Tech500/EoRa-PI-Foundation/Docs/Pin # to GPIO #.jpg

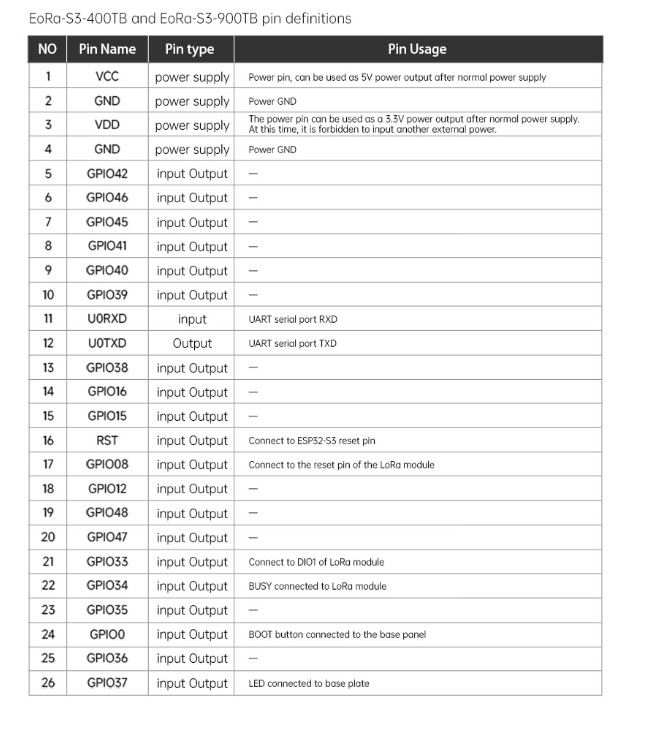
Docs/Pin # to GPIO #.jpg
