Tech500/EoRa-PI-Foundation/Docs/Pin callouts.jpg

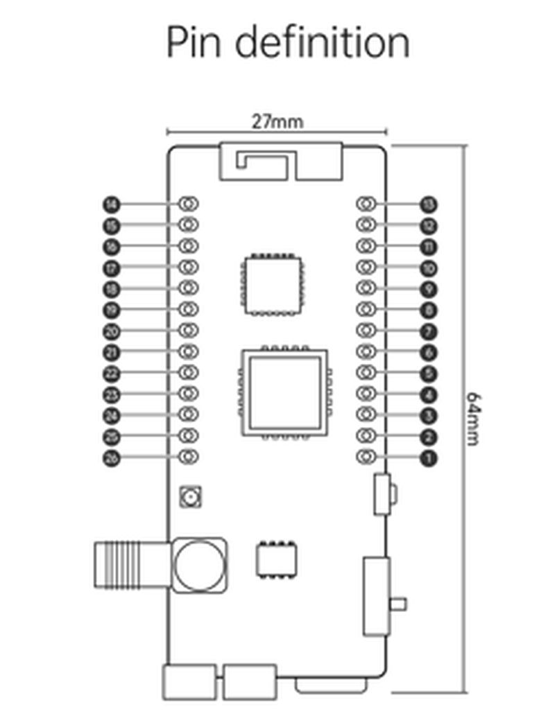
Docs/Pin callouts.jpg
