Tech500/EoRa-PI-Foundation/EoRa-PI-Foundation --Receiver.png

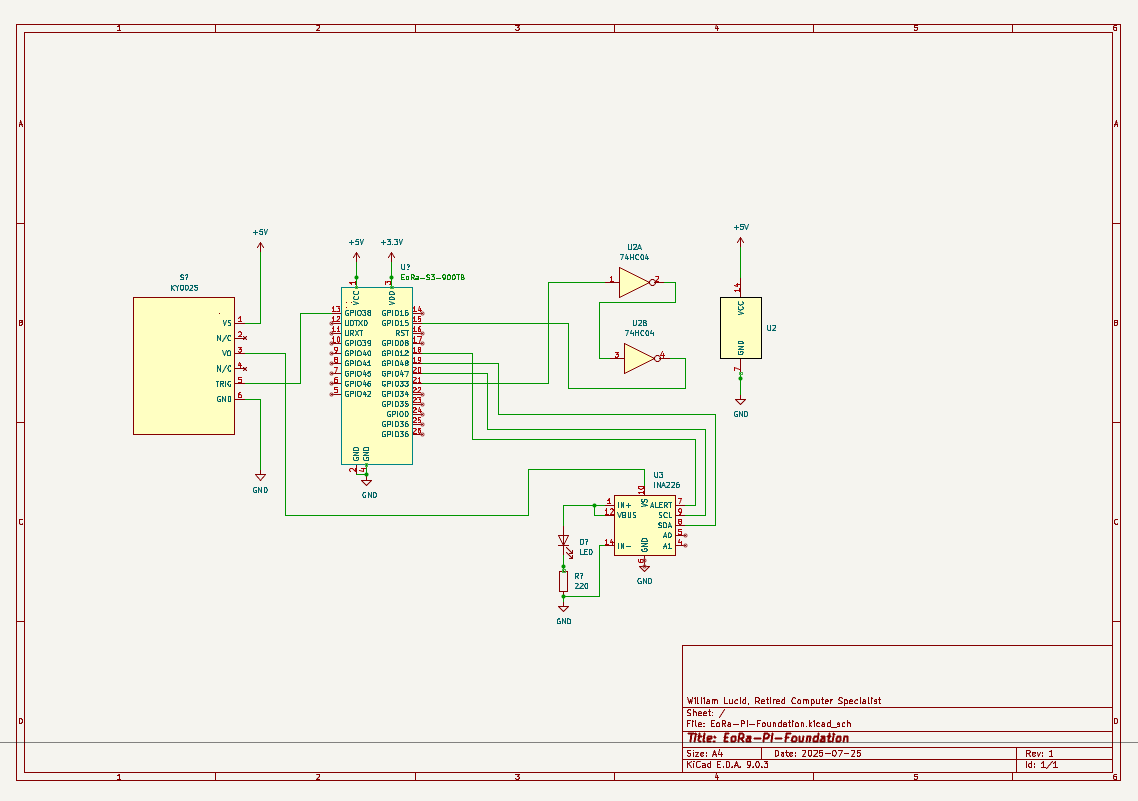
EoRa-PI-Foundation --Receiver.png
