Tech500/EoRa-PI-Foundation/EoRa-PI-Foundation --Transmitter.png

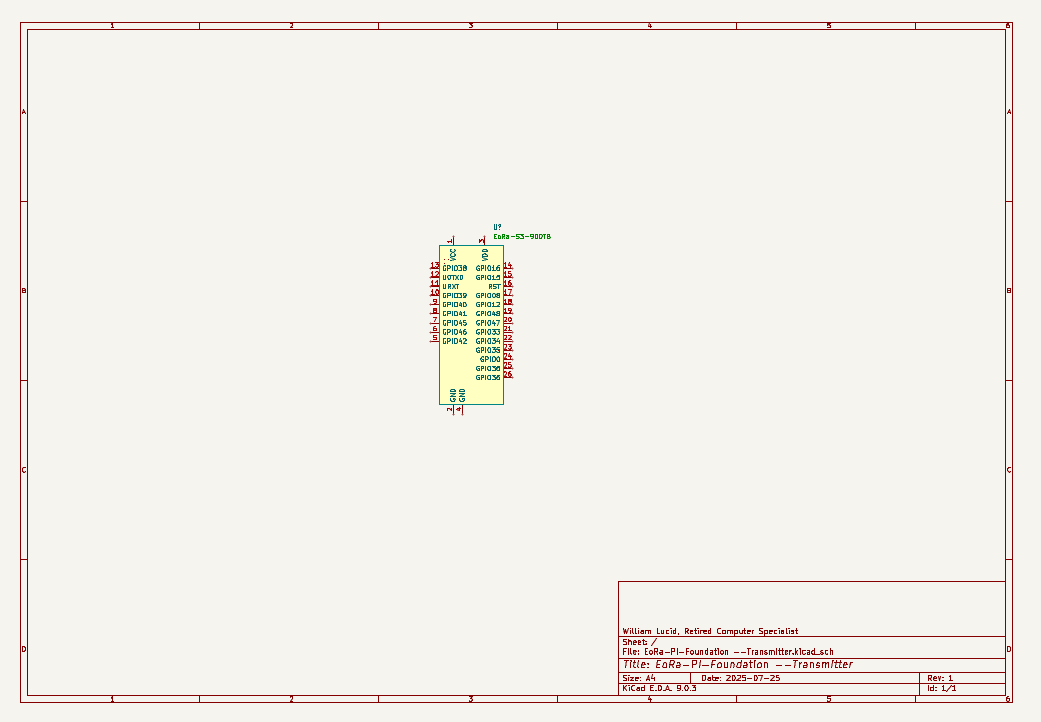
EoRa-PI-Foundation --Transmitter.png
