Tech500/EoRa-PI-Foundation/(commit log)

2025-07-24 Update EoRa_PI_WOR_Receiver.ino
    Deep Sleep Working ! ~80 mA Wake ~10 mA Sleep
    High current in deep sleep; Olead and SD Card disabled in "utilites.h" file (Ebyte file).
2025-07-28 Power Management
